Sean-AU-Grant/32-bit-RiscV-CPU/README.md

# 32-bit-RiscV-CPU
A 32-bit RISC-V based CPU personal project. I am always making improvements as I grow and learn as an engineer.
