Sean-AU-Grant/32-bit-RiscV-CPU/L1_Cache/Cache Test Script.xlsx

new_inst | rs1 [31:0] | imm [31:0] | store_data [31:0] | funct3 [2:0] | ld_st | id [5:0] | addr_ptr [5:0]
1 | 0 | 0 | 0 | 2 | 0 | 0 | 0
1 | 4 | 0 | 1 | 2 | 0 | 1 | 1
1 | 8 | 0 | 2 | 2 | 0 | 2 | 2
1 | 12 | 0 | 3 | 2 | 0 | 3 | 3
1 | 16 | 0 | 4 | 2 | 0 | 4 | 4
1 | 20 | 0 | 5 | 2 | 0 | 5 | 5
1 | 24 | 0 | 6 | 2 | 0 | 6 | 6
1 | 28 | 0 | 7 | 2 | 0 | 7 | 7
1 | 32 | 0 | 8 | 2 | 0 | 8 | 8
1 | 36 | 0 | 9 | 2 | 0 | 9 | 9
1 | 40 | 0 | 10 | 2 | 0 | 10 | 10
1 | 44 | 0 | 11 | 2 | 0 | 11 | 11
1 | 48 | 0 | 12 | 2 | 0 | 12 | 12
1 | 52 | 0 | 13 | 2 | 0 | 13 | 13
1 | 56 | 0 | 14 | 2 | 0 | 14 | 14
1 | 60 | 0 | 15 | 2 | 0 | 15 | 15
1 | 64 | 0 | 16 | 2 | 0 | 16 | 16
1 | 68 | 0 | 17 | 2 | 0 | 17 | 17
1 | 72 | 0 | 18 | 2 | 0 | 18 | 18
1 | 76 | 0 | 19 | 2 | 0 | 19 | 19
1 | 80 | 0 | 20 | 2 | 0 | 20 | 20
1 | 84 | 0 | 21 | 2 | 0 | 21 | 21
1 | 88 | 0 | 22 | 2 | 0 | 22 | 22
1 | 92 | 0 | 23 | 2 | 0 | 23 | 23
1 | 96 | 0 | 24 | 2 | 0 | 24 | 24
1 | 100 | 0 | 25 | 2 | 0 | 25 | 25
1 | 104 | 0 | 26 | 2 | 0 | 26 | 26
1 | 108 | 0 | 27 | 2 | 0 | 27 | 27
1 | 112 | 0 | 28 | 2 | 0 | 28 | 28
1 | 116 | 0 | 29 | 2 | 0 | 29 | 29
1 | 120 | 0 | 30 | 2 | 0 | 30 | 30
1 | 124 | 0 | 31 | 2 | 0 | 31 | 31
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
