Sean-AU-Grant/32-bit-RiscV-CPU/(commit log)

2025-11-14 L1 Cache
    4 way set associative L1 cache with python golden model and automated test script
    [Cache Test Script.xlsx, micro_insts.csv, sim_results.csv]
2025-11-14 Rename Cache Test Script.xlsx to L1_Cache/Cache Test Script.xlsx
    [Cache Test Script.xlsx]
2025-11-14 Update and rename micro_insts.csv to L1_Cache/micro_insts.csv
    [micro_insts.csv]
